GreenGiant73/ChemE_Car_Electrical_Team_2019-2020/Box 2/Images/analog-png-7.png

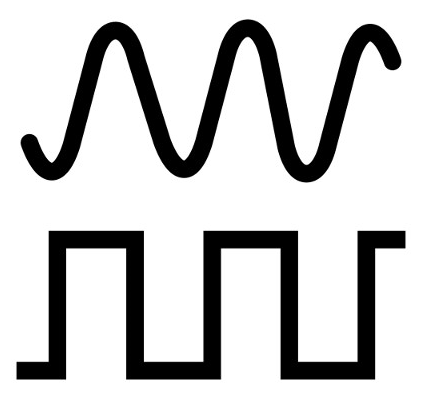
Box 2/Images/analog-png-7.png
