GreenGiant73/ChemE_Car_Electrical_Team_2019-2020/Box 2/Images/t1TwA.jpg

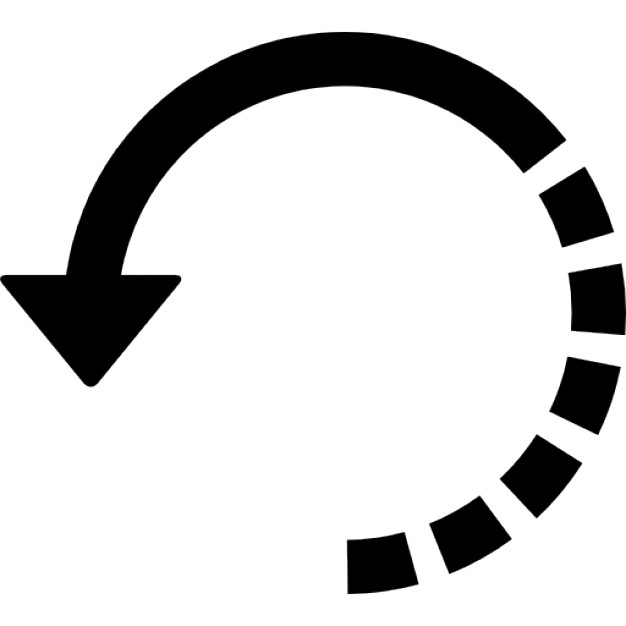
Box 2/Images/t1TwA.jpg
