GreenGiant73/ChemE_Car_Electrical_Team_2019-2020/Electrical Team Materials.xlsx

Electrical Team Material Order Form
Date | Material | Description | Quantity | Link
2019-09-15 | Breadboards (x6) | DEYUE breadboard Set Prototype Board - 6 PCS 400 Pin Solderless Board Kit for Raspberry pi and Arduino Project | 1 | https://www.amazon.com/DEYUE-breadboard-Set-Prototype-Board/dp/B07LFD4LT6?s=gateway
2019-09-15 | Jumper Wires (x240) | DEYUE Jumper Wires Set - 240 PCs 3in1 breadboard Wires, Male to Male, Female to Male, Female to Female | 1 | https://www.amazon.com/DEYUE-breadboard-Set-Prototype-Board/dp/B07LFCLMGW?s=gateway
2019-09-15 | Arduino Nano (x1) | The Arduino Nano is a small, complete, and breadboard-friendly board based on the ATmega328P (Arduino Nano 3.x). It has more or less the same functionality of the Arduino Duemilanove, but in a different package. It lacks only a DC power jack, and works with a Mini-B USB cable instead of a standard one. | 2 | https://store.arduino.cc/usa/arduino-nano
2019-09-15 | USB-A to mini-B cord (x1) | AmazonBasics USB 2.0 Cable - A-Male to Mini-B Cord - 6 Feet (1.8 Meters) | 1 | https://www.amazon.com/AmazonBasics-USB-2-0-Cable-Male/dp/B00NH11N5A?ref_=fsclp_pl_dp_1
2019-09-15 | Ambient Light Sensors (x5) | Ambient Light Sensors Ambient Light Sensor (5 pieces) | 1 | https://www.amazon.com/Ambient-Light-Sensors-Sensor-pieces/dp/B00LWM08WA
