GreenGiant73/ChemE_Car_Electrical_Team_2019-2020/ChemE_Car_Board_v1.dxf

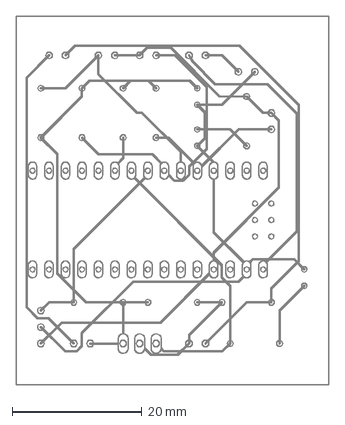
[picture p3: CAD file, 2020-01-28]
ChemE_Car_Board_v1.dxf
48.2 x 56.8 mm
