GreenGiant73/ChemE_Car_Electrical_Team_2019-2020/(list of files, drawings)

Other design files:
ChemE Car Electrical Team 2019.fzz
