GreenGiant73/ChemE_Car_Electrical_Team_2019-2020/new_and_improved_board.brd

## EAGLE design new_and_improved_board.brd (2020-02-09)

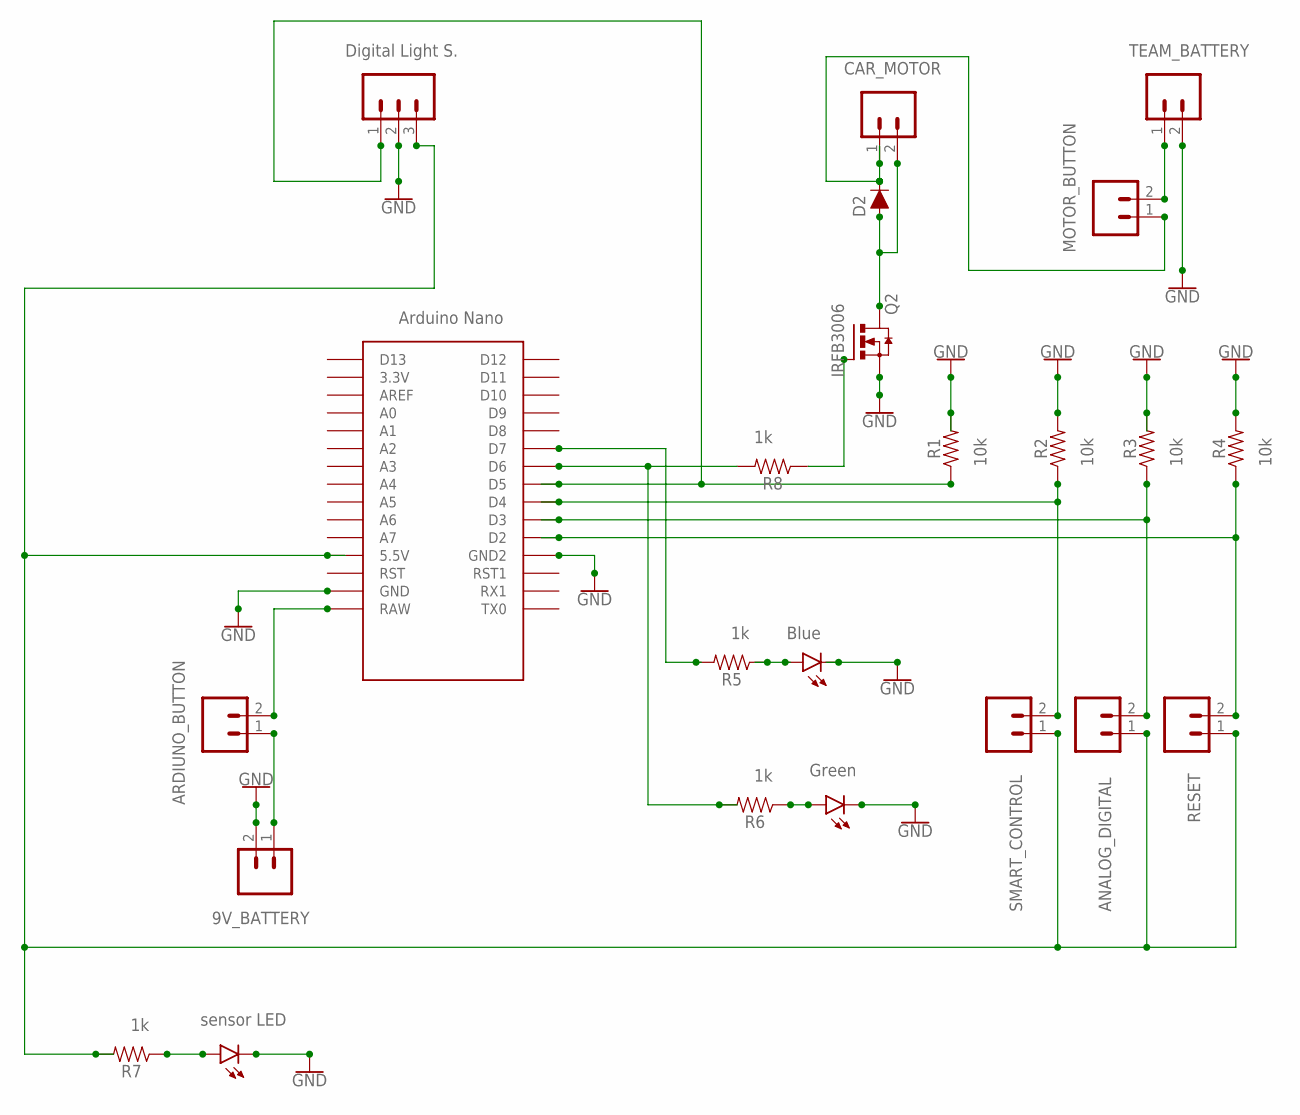
[picture p4: schematic new_and_improved_board.sch]

Parts:
D2: 200mA/100V/1V; DIODE-1N4148
D4, D5, D6: LED3MM; LED_3MM
J1, J2, J3: CONN_02; 1X02
J4: 455-1750-1-ND; 1X03
Q2: IRF3704L-V; TO262-V
R1, R2, R3, R4, R5, R6, R7, R8: 1M; AXIAL-0.3
S1, S2, S3, S4, S5: CONN_02; 1X02
U$1: NANO

Connections:
5V: J4.3, R7.P$2 (2), S2.1, S4.1, S5.1, U$1.5V (5.5V)
9V: S1.2, U$1.RAW
9VBAT: J2.1, S1.1
GND: D4.K (C), D5.K (C), D6.K (C), J2.2, J3.2, J4.2, Q2.3 (S), R1.P$2 (2), R2.P$2 (2), R3.P$2 (2), R4.P$2 (2), U$1.GND, U$1.GND1 (GND2)
unnamed: R6.P$2 (2), R8.P$2 (2), U$1.D6
unnamed: D2.A, J1.2, Q2.2 (D)
unnamed: Q2.1 (G), R8.P$1 (1)
unnamed: J4.1, R1.P$1 (1), U$1.D5
unnamed: R2.P$1 (1), S2.2, U$1.D4
unnamed: R3.P$1 (1), S4.2, U$1.D3
unnamed: R4.P$1 (1), S5.2, U$1.D2
unnamed: R5.P$2 (2), U$1.D7
unnamed: D4.A, R5.P$1 (1)
unnamed: D5.A, R6.P$1 (1)
unnamed: D2.C, J1.1, S3.1
unnamed: J3.1, S3.2
unnamed: D6.A, R7.P$1 (1)

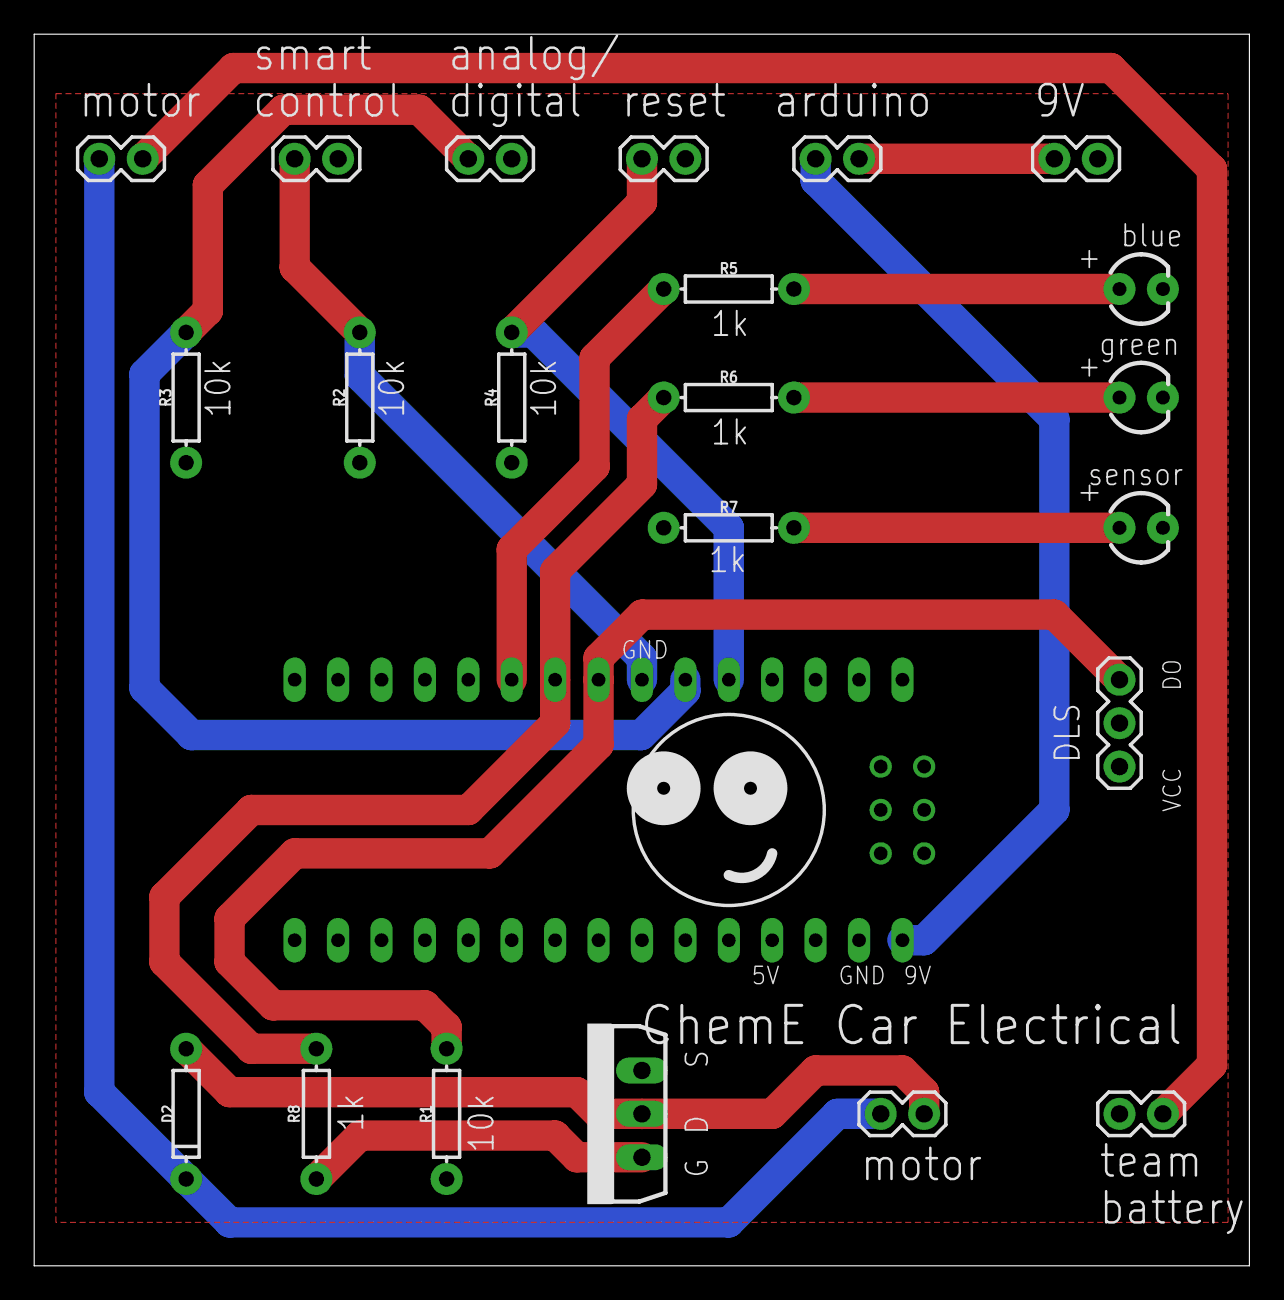
[picture p5: board new_and_improved_board.brd from above]

Board: 2 copper layers, 71.1 x 72.1 mm, 23 parts (0 on the bottom side), 17 nets.
