GreenGiant73/ChemE_Car_Electrical_Team_2019-2020/ArduinoPCB_test.brd

## EAGLE design ArduinoPCB_test.brd (2020-01-02)

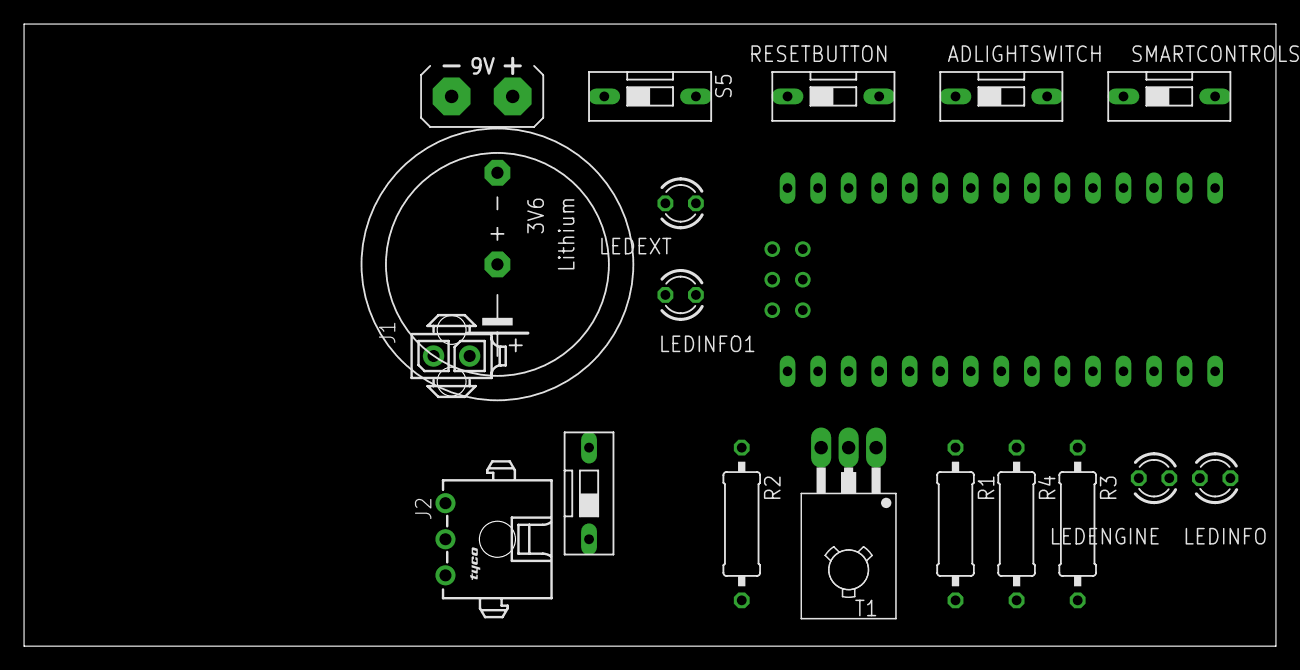
[picture p6: board ArduinoPCB_test.brd from above]

Board: 2 copper layers, 104.1 x 51.7 mm, 20 parts (0 on the bottom side), 13 nets, no tracks yet.

Parts:
ADLIGHTSWITCH: DS-01
FRAME1: FRAME-LETTER; CREATIVE_COMMONS
G1: AB9V
G2: SL-340/P3.6V
J1: 794681-2
J2: 1445055-3
LEDENGINE: LED3MM
LEDEXT: LED3MM
LEDINFO, LEDINFO1: LED3MM
R1, R2, R3, R4: 0309/12
RESETBUTTON: DS-01
S5, S6: DS-01
SMARTCONTROLSWITCH: DS-01
T1: 2N4923; TO126
U$1: NANO

Connections:
unnamed: ADLIGHTSWITCH.2, R4.1, U$1.D3
unnamed: R3.1, SMARTCONTROLSWITCH.2, U$1.D4
unnamed: G2.+, S6.1
unnamed: G1.+, S5.1
unnamed: LEDINFO1.A, T1.1
unnamed: G1.-, G2.-, J1.2, J2.2, LEDENGINE.K, LEDEXT.K, LEDINFO.K, LEDINFO1.K, R1.2, R2.1, R3.2, R4.2, T1.3, U$1.GND
unnamed: ADLIGHTSWITCH.1, J2.1, LEDEXT.A, RESETBUTTON.1, SMARTCONTROLSWITCH.1, U$1.5V
unnamed: LEDENGINE.A, U$1.D6
unnamed: LEDINFO.A, U$1.D7
unnamed: S5.2, U$1.RAW
unnamed: J2.3, R2.2
unnamed: R1.1, RESETBUTTON.2, U$1.D2
unnamed: J1.1, S6.2, T1.2
