GreenGiant73/ChemE_Car_Electrical_Team_2019-2020/(commit log)

2019-09-15 Added list of materials
    [Electrical Team Materials.xlsx]
2019-10-25 PCB Design
    [ArduinoPCB.sch]
2019-10-25 added pcb
    [ArduinoPCB.brd, ArduinoPCB.sch]
2019-11-02 Updated PCB schematic
    [ArduinoPCB.sch]
2019-11-02 Fritzing Schematic
    [ChemE Car Electrical Team 2019.fzz]
2019-11-09 Updated Board
    [ArduinoPCB.sch]
2019-11-09 updated PCB
    [ArduinoPCB.brd]
2020-01-02 added through holes for motor connection and through holes for sensor connection. also changed PCB layout.
    [ArduinoPCB_test.sch]
2020-01-02 Added New Schematic
    [mainboard.sch]
2020-01-04 new schematic modeling the shield layout
    [ArduinoPCB_test.brd, new_board.sch]
2020-01-04 modifications made to ArduinoPCB_test
    [ArduinoPCB_test.sch]
2020-01-05 added analog/digital switch
    [new_board.sch]
2020-01-05 routing PCB layout
    [new_board.brd, new_board.sch]
2020-01-06 finished labeling signals and buttons
    [new_board.sch]
2020-01-07 switched out switches for through-holes
    [new_board.sch]
2020-01-07 added team name
    [new_board.brd]
2020-01-07 resize board
    [new_board.brd]
2020-01-25 thicker wire lines
2020-01-25 thicker lines
    [ArduinoPCB.brd]
2020-01-28 added ground and power planes, and changed resistor values/added resistor after the mosfet gate
    [ChemE_Car_Board_v1.dxf, new_and_improved_board.brd, new_and_improved_board.sch, new_board.brd, new_board.sch]
2020-01-31 added æsthetically pleasing features
    [new_and_improved_board.brd]
2020-02-06 resdimensioning the circuit box
    [new_and_improved_board.brd]
2020-02-09 finalizing box design
    [new_and_improved_board.brd]
